TheWaffleGuy/EPROM-programmer/3D/CUI_DEVICES_HSE-B2111-038.step

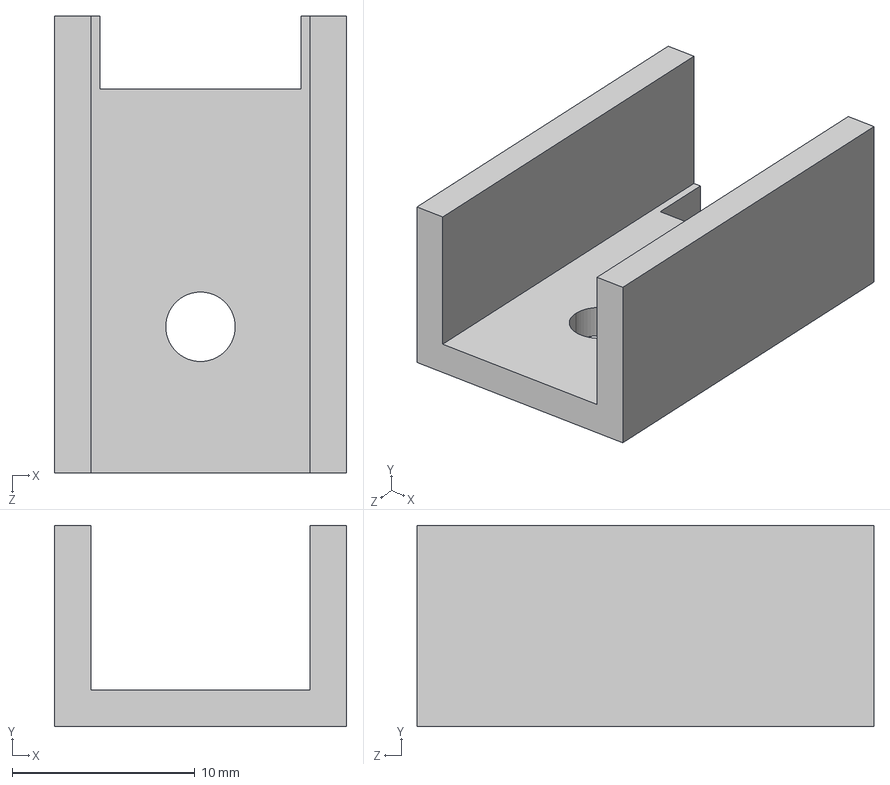
[picture p1: CAD file, 2024-07-29]
3D/CUI_DEVICES_HSE-B2111-038.step
16.0 x 11.0 x 25.0 mm
