TheWaffleGuy/EPROM-programmer/3D/224-1275-00-0602J--3DModel-STEP-56544.STEP

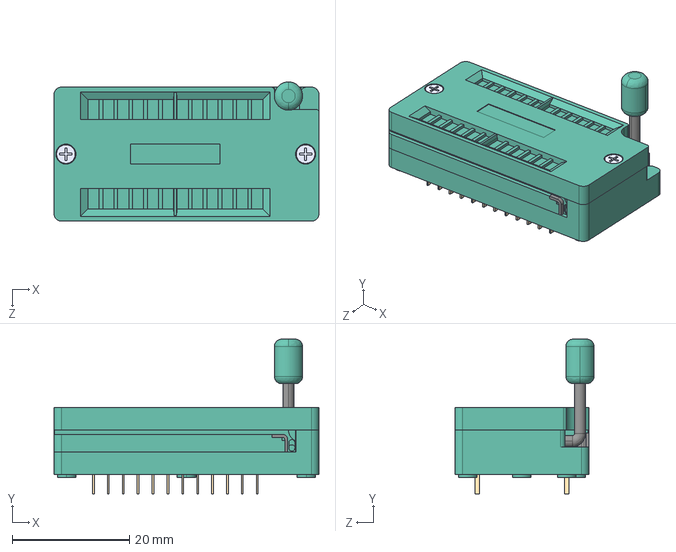
[picture p2: CAD file, 2023-07-26]
3D/224-1275-00-0602J--3DModel-STEP-56544.STEP
45.2 x 26.4 x 23.7 mm
