TheWaffleGuy/EPROM-programmer/EPROM-programmer.kicad_pcb

## KiCad design EPROM-programmer.kicad_pcb (2025-09-11)

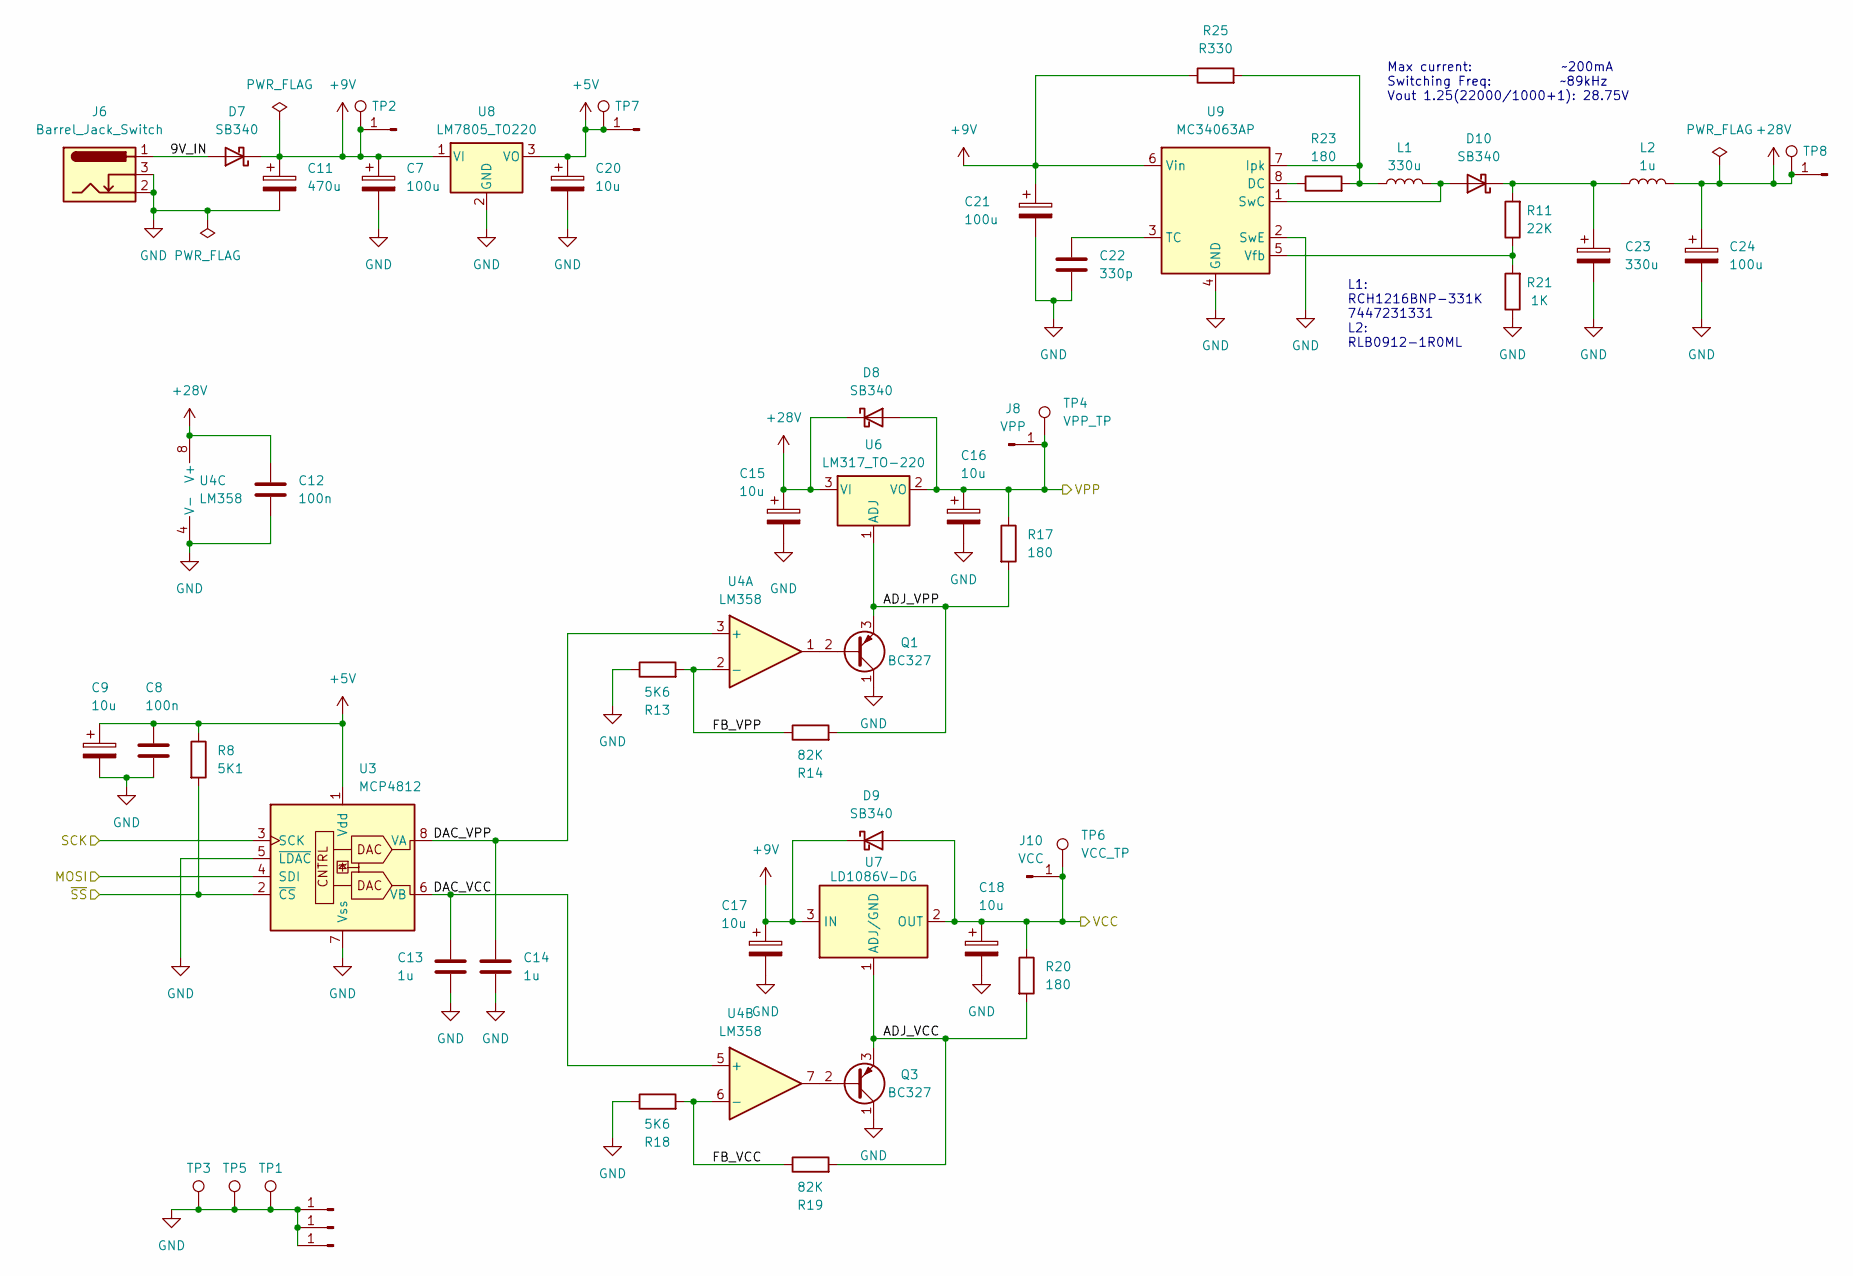
[picture p3: schematic Power.kicad_sch]

Parts:
C7, C21, C24: 100u; CP_Radial_D6.3mm_P2.50mm
C8, C12: 100n; C_Rect_L4.6mm_W3.0mm_P2.50mm_MKS02_FKP02
C9, C15, C16, C17, C18: 10u; C_Rect_L4.6mm_W3.0mm_P2.50mm_MKS02_FKP02
C11: 470u; CP_Radial_D10.0mm_P5.00mm
C13, C14: 1u; C_Rect_L4.6mm_W3.0mm_P2.50mm_MKS02_FKP02
C20: 10u; CP_Radial_D6.3mm_P2.50mm
C22: 330p; C_Rect_L4.6mm_W3.0mm_P2.50mm_MKS02_FKP02
C23: 330u; CP_Radial_D10.0mm_P5.00mm
D7, D8, D9, D10: SB340; D_DO-201AD_P5.08mm_Vertical_KathodeUp
J3, J5, J9: GND; PinHeader_1x01_P2.54mm_Vertical
J4: 9V; PinHeader_1x01_P2.54mm_Vertical
J6: Barrel_Jack_Switch; BarrelJack_Horizontal
J8: VPP; PinHeader_1x01_P2.54mm_Vertical
J10: VCC; PinHeader_1x01_P2.54mm_Vertical
J11: 5V; PinHeader_1x01_P2.54mm_Vertical
J12: 28V; PinHeader_1x01_P2.54mm_Vertical
L1: 330u; L_Radial_D12.5mm_P4.00mm_5.00mm
L2: 1u; L_Radial_D8.7mm_P5.00mm_Fastron_07HCP
Q1, Q3: BC327; TO-92_Inline_Wide
R8: 5K1; R_Axial_DIN0207_L6.3mm_D2.5mm_P10.16mm_Horizontal
R11: 22K; R_Axial_DIN0207_L6.3mm_D2.5mm_P10.16mm_Horizontal
R13, R18: 5K6; R_Axial_DIN0207_L6.3mm_D2.5mm_P10.16mm_Horizontal
R14, R19: 82K; R_Axial_DIN0207_L6.3mm_D2.5mm_P10.16mm_Horizontal
R17, R20, R23: 180; R_Axial_DIN0207_L6.3mm_D2.5mm_P10.16mm_Horizontal
R21: 1K; R_Axial_DIN0207_L6.3mm_D2.5mm_P10.16mm_Horizontal
R25: R330; R_Axial_DIN0207_L6.3mm_D2.5mm_P10.16mm_Horizontal
TP1, TP3, TP5: GND; TestPoint_Pad_2.0x2.0mm
TP2: 12V; TestPoint_Pad_2.0x2.0mm
TP4: VPP_TP; TestPoint_Pad_2.0x2.0mm
TP6: VCC_TP; TestPoint_Pad_2.0x2.0mm
TP7: 5V; TestPoint_Pad_2.0x2.0mm
TP8: 28V; TestPoint_Pad_2.0x2.0mm
U3: MCP4812; DIP-8_W7.62mm_Socket
U4: LM358; DIP-8_W7.62mm_Socket
U6: LM317_TO-220; TO-220-3_Vertical
U7: LD1086V-DG; TO-220-3_Horizontal_TabDown
U8: LM7805_TO220; TO-220-3_Horizontal_TabDown
U9: MC34063AP; DIP-8_W7.62mm

Connections:
+5V: C8.1, C9.1, C20.1, J11.1, R8.1, TP7.1, U3.1 (Vdd), U8.3 (VO); also elsewhere on the board
+9V: C7.1, C11.1, C17.1, C21.1, D7.1 (K), D9.1 (K), J4.1, R25.1, TP2.1, U7.3 (IN), U8.1 (VI), U9.6 (Vin)
+28V: C12.1, C15.1, C24.1, D8.1 (K), J12.1, L2.2, TP8.1, U4.8 (V+), U6.3 (VI)
/Power/9V_IN: D7.2 (A), J6.1
/Power/ADJ_VCC: Q3.3 (E), R19.2, R20.2, U7.1 (ADJ/GND)
/Power/ADJ_VPP: Q1.3 (E), R14.2, R17.2, U6.1 (ADJ)
/Power/DAC_VCC: C13.1, U3.6 (VB), U4.5 (+)
/Power/DAC_VPP: C14.1, U3.8 (VA), U4.3 (+)
/Power/FB_VCC: R18.2, R19.1, U4.6 (-)
/Power/FB_VPP: R13.2, R14.1, U4.2 (-)
/Power/VCC: C18.1, D9.2 (A), J10.1, R20.1, TP6.1, U7.2 (OUT); also elsewhere on the board
/Power/VPP: C16.1, D8.2 (A), J8.1, R17.1, TP4.1, U6.2 (VO); also elsewhere on the board
/Power/~SS: R8.2, U3.2 (~CS); also elsewhere on the board
/Programmer/MOSI: U3.4 (SDI); also elsewhere on the board
/Programmer/SCK: U3.3 (SCK); also elsewhere on the board
GND: C7.2, C8.2, C9.2, C11.2, C12.2, C13.2, C14.2, C15.2, C16.2, C17.2, C18.2, C20.2, C21.2, C22.2, C23.2, C24.2, J3.1, J5.1, J6.2, J6.3, J9.1, Q1.1 (C), Q3.1 (C), R13.1, R18.1, R21.1, TP1.1, TP3.1, TP5.1, U3.5 (~LDAC), U3.7 (Vss), U4.4 (V-), U8.2 (GND), U9.2 (SwE), U9.4 (GND); also elsewhere on the board
unnamed: D10.2 (A), L1.2, U9.1 (SwC)
unnamed: C23.1, D10.1 (K), L2.1, R11.2
unnamed: Q1.2 (B), U4.1
unnamed: Q3.2 (B), U4.7
unnamed: R23.1, U9.8 (DC)
unnamed: L1.1, R23.2, R25.2, U9.7 (Ipk)
unnamed: C22.1, U9.3 (TC)
unnamed: R11.1, R21.2, U9.5 (Vfb)

Notes on the sheet:
L1: RCH1216BNP-331K 7447231331 L2: RLB0912-1R0ML
Max current: ~200mA Switching Freq: ~89kHz Vout 1.25(22000/1000+1): 28.75V

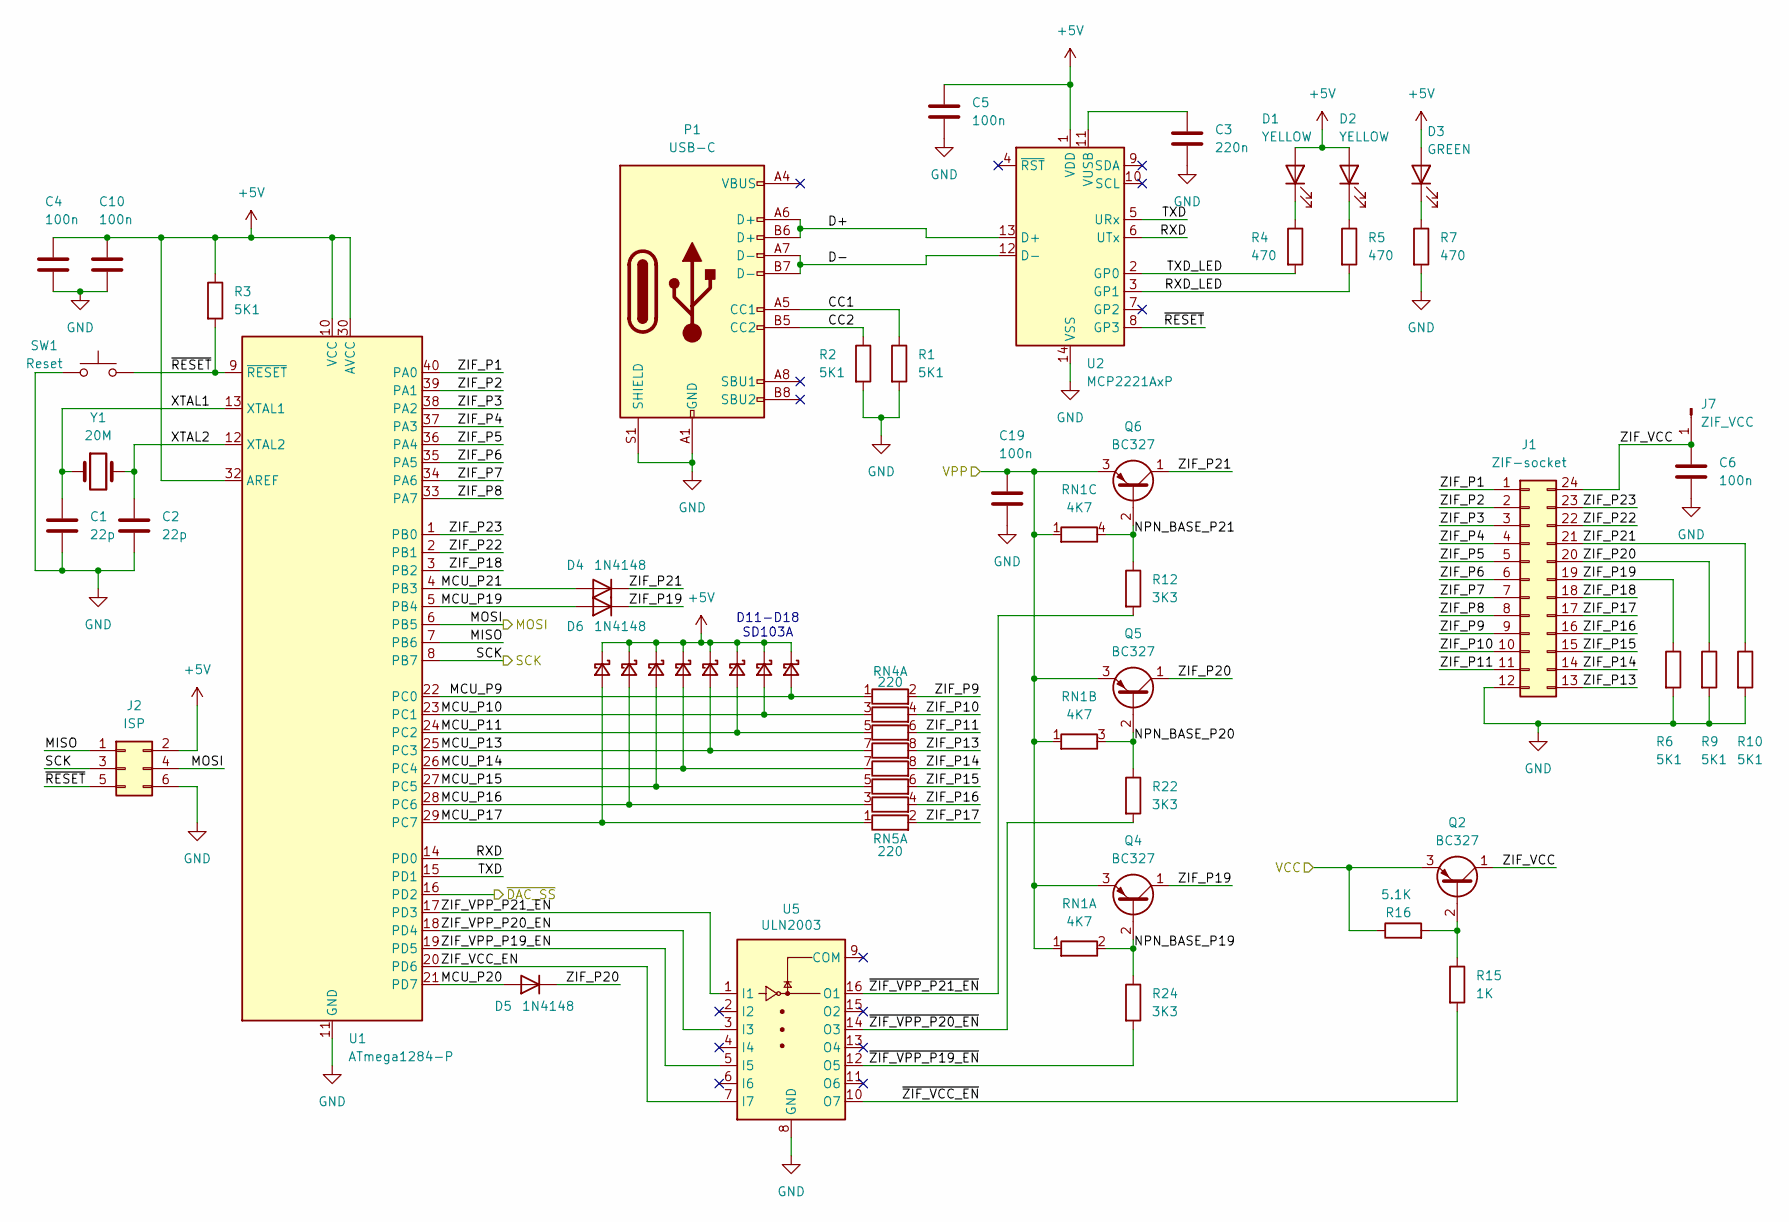
[picture p4: schematic Programmer.kicad_sch]

Parts:
C1, C2: 22p; C_Rect_L4.6mm_W3.0mm_P2.50mm_MKS02_FKP02
C3: 220n; C_Rect_L4.6mm_W3.0mm_P2.50mm_MKS02_FKP02
C4, C5, C6, C10, C19: 100n; C_Rect_L4.6mm_W3.0mm_P2.50mm_MKS02_FKP02
D1, D2: YELLOW; LED_D3.0mm
D3: GREEN; LED_D3.0mm
D4, D5, D6: 1N4148; D_DO-35_SOD27_P7.62mm_Horizontal
D11, D12, D13, D14, D15, D16, D17, D18: SD103A; D_DO-35_SOD27_P7.62mm_Horizontal
J1: ZIF-socket; DIP_Socket-24_W11.9_W12.7_W15.24_W17.78_W18.5_3M_224-1275-0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
J2: ISP; IDC-Header_2x03_P2.54mm_Vertical
J7: ZIF_VCC; PinHeader_1x01_P2.54mm_Vertical
P1: USB-C; USB_C_Receptacle_GCT_USB4085
Q2, Q4, Q5, Q6: BC327; TO-92_Inline_Wide
R1, R2, R3, R6, R9, R10: 5K1; R_Axial_DIN0207_L6.3mm_D2.5mm_P10.16mm_Horizontal
R4, R5, R7: 470; R_Axial_DIN0207_L6.3mm_D2.5mm_P10.16mm_Horizontal
R12, R22, R24: 3K3; R_Axial_DIN0207_L6.3mm_D2.5mm_P10.16mm_Horizontal
R15: 1K; R_Axial_DIN0207_L6.3mm_D2.5mm_P10.16mm_Horizontal
R16: 5.1K; R_Axial_DIN0207_L6.3mm_D2.5mm_P10.16mm_Horizontal
RN1: 4K7; R_Array_SIP4
RN4, RN5: 220; R_Array_SIP8
SW1: Reset; SW_PUSH_6mm
U1: ATmega1284-P; DIP-40_W15.24mm_Socket
U2: MCP2221AxP; DIP-14_W7.62mm_Socket
U5: ULN2003; DIP-16_W7.62mm
Y1: 20M; Crystal_HC49-U_Vertical

Connections:
+5V: C4.1, C5.1, C10.1, D1.2 (A), D2.2 (A), D3.2 (A), D11.1 (K), D12.1 (K), D13.1 (K), D14.1 (K), D15.1 (K), D16.1 (K), D17.1 (K), D18.1 (K), J2.2, R3.1, U1.10 (VCC), U1.30 (AVCC), U1.32 (AREF), U2.1 (VDD); also elsewhere on the board
/Power/VCC: Q2.3 (E), R16.1; also elsewhere on the board
/Power/VPP: C19.1, Q4.3 (E), Q5.3 (E), Q6.3 (E), RN1.1 (R1); also elsewhere on the board
/Power/~SS: U1.16 (PD2); also elsewhere on the board
/Programmer/CC1: P1.A5 (CC1), R1.1
/Programmer/CC2: P1.B5 (CC2), R2.1
/Programmer/D+: P1.A6 (D+), P1.B6 (D+), U2.13 (D+)
/Programmer/D-: P1.A7 (D-), P1.B7 (D-), U2.12 (D-)
/Programmer/MCU_P9: D18.2 (A), RN4.1 (R1.1), U1.22 (PC0)
/Programmer/MCU_P10: D17.2 (A), RN4.3 (R2.1), U1.23 (PC1)
/Programmer/MCU_P11: D16.2 (A), RN4.5 (R3.1), U1.24 (PC2)
/Programmer/MCU_P13: D15.2 (A), RN4.7 (R4.1), U1.25 (PC3)
/Programmer/MCU_P14: D14.2 (A), RN5.7 (R4.1), U1.26 (PC4)
/Programmer/MCU_P15: D13.2 (A), RN5.5 (R3.1), U1.27 (PC5)
/Programmer/MCU_P16: D12.2 (A), RN5.3 (R2.1), U1.28 (PC6)
/Programmer/MCU_P17: D11.2 (A), RN5.1 (R1.1), U1.29 (PC7)
/Programmer/MCU_P19: D6.2 (A), U1.5 (PB4)
/Programmer/MCU_P20: D5.2 (A), U1.21 (PD7)
/Programmer/MCU_P21: D4.2 (A), U1.4 (PB3)
/Programmer/MISO: J2.1, U1.7 (PB6)
/Programmer/MOSI: J2.4, U1.6 (PB5); also elsewhere on the board
/Programmer/NPN_BASE_P19: Q4.2 (B), R24.1, RN1.2 (R1.2)
/Programmer/NPN_BASE_P20: Q5.2 (B), R22.1, RN1.3 (R2.2)
/Programmer/NPN_BASE_P21: Q6.2 (B), R12.1, RN1.4 (R3.2)
/Programmer/RXD: U1.14 (PD0), U2.6 (UTx)
/Programmer/RXD_LED: R5.2, U2.3 (GP1)
/Programmer/SCK: J2.3, U1.8 (PB7); also elsewhere on the board
/Programmer/TXD: U1.15 (PD1), U2.5 (URx)
/Programmer/TXD_LED: R4.2, U2.2 (GP0)
/Programmer/XTAL1: C1.1, U1.13 (XTAL1), Y1.1
/Programmer/XTAL2: C2.1, U1.12 (XTAL2), Y1.2
/Programmer/ZIF_P1: J1.1, U1.40 (PA0)
/Programmer/ZIF_P2: J1.2, U1.39 (PA1)
/Programmer/ZIF_P3: J1.3, U1.38 (PA2)
/Programmer/ZIF_P4: J1.4, U1.37 (PA3)
/Programmer/ZIF_P5: J1.5, U1.36 (PA4)
/Programmer/ZIF_P6: J1.6, U1.35 (PA5)
/Programmer/ZIF_P7: J1.7, U1.34 (PA6)
/Programmer/ZIF_P8: J1.8, U1.33 (PA7)
/Programmer/ZIF_P9: J1.9, RN4.2 (R1.2)
/Programmer/ZIF_P10: J1.10, RN4.4 (R2.2)
/Programmer/ZIF_P11: J1.11, RN4.6 (R3.2)
/Programmer/ZIF_P13: J1.13, RN4.8 (R4.2)
/Programmer/ZIF_P14: J1.14, RN5.8 (R4.2)
/Programmer/ZIF_P15: J1.15, RN5.6 (R3.2)
/Programmer/ZIF_P16: J1.16, RN5.4 (R2.2)
/Programmer/ZIF_P17: J1.17, RN5.2 (R1.2)
/Programmer/ZIF_P18: J1.18, U1.3 (PB2)
/Programmer/ZIF_P19: D6.1 (K), J1.19, Q4.1 (C), R6.1
/Programmer/ZIF_P20: D5.1 (K), J1.20, Q5.1 (C), R9.1
/Programmer/ZIF_P21: D4.1 (K), J1.21, Q6.1 (C), R10.1
/Programmer/ZIF_P22: J1.22, U1.2 (PB1)
/Programmer/ZIF_P23: J1.23, U1.1 (PB0)
/Programmer/ZIF_VCC: C6.1, J1.24, J7.1, Q2.1 (C)
/Programmer/ZIF_VCC_EN: U1.20 (PD6), U5.7 (I7)
/Programmer/ZIF_VPP_P19_EN: U1.19 (PD5), U5.5 (I5)
/Programmer/ZIF_VPP_P20_EN: U1.18 (PD4), U5.3 (I3)
/Programmer/ZIF_VPP_P21_EN: U1.17 (PD3), U5.1 (I1)
/Programmer/~RESET: J2.5, R3.2, SW1.2, U1.9 (~RESET), U2.8 (GP3)
/Programmer/~ZIF_VCC_EN: R15.2, U5.10 (O7)
/Programmer/~ZIF_VPP_P19_EN: R24.2, U5.12 (O5)
/Programmer/~ZIF_VPP_P20_EN: R22.2, U5.14 (O3)
/Programmer/~ZIF_VPP_P21_EN: R12.2, U5.16 (O1)
GND: C1.2, C2.2, C3.2, C4.2, C5.2, C6.2, C10.2, C19.2, J1.12, J2.6, P1.A1 (GND), P1.A12 (GND), P1.B1 (GND), P1.B12 (GND), P1.S1 (SHIELD), R1.2, R2.2, R6.2, R7.2, R9.2, R10.2, SW1.1, U1.11 (GND), U1.31 (GND), U2.14 (VSS), U5.8 (GND); also elsewhere on the board
unnamed: D1.1 (K), R4.1
unnamed: D2.1 (K), R5.1
unnamed: D3.1 (K), R7.1
unnamed: Q2.2 (B), R15.1, R16.2
unnamed: C3.1, U2.11 (VUSB)

Notes on the sheet:
D11-D18 SD103A

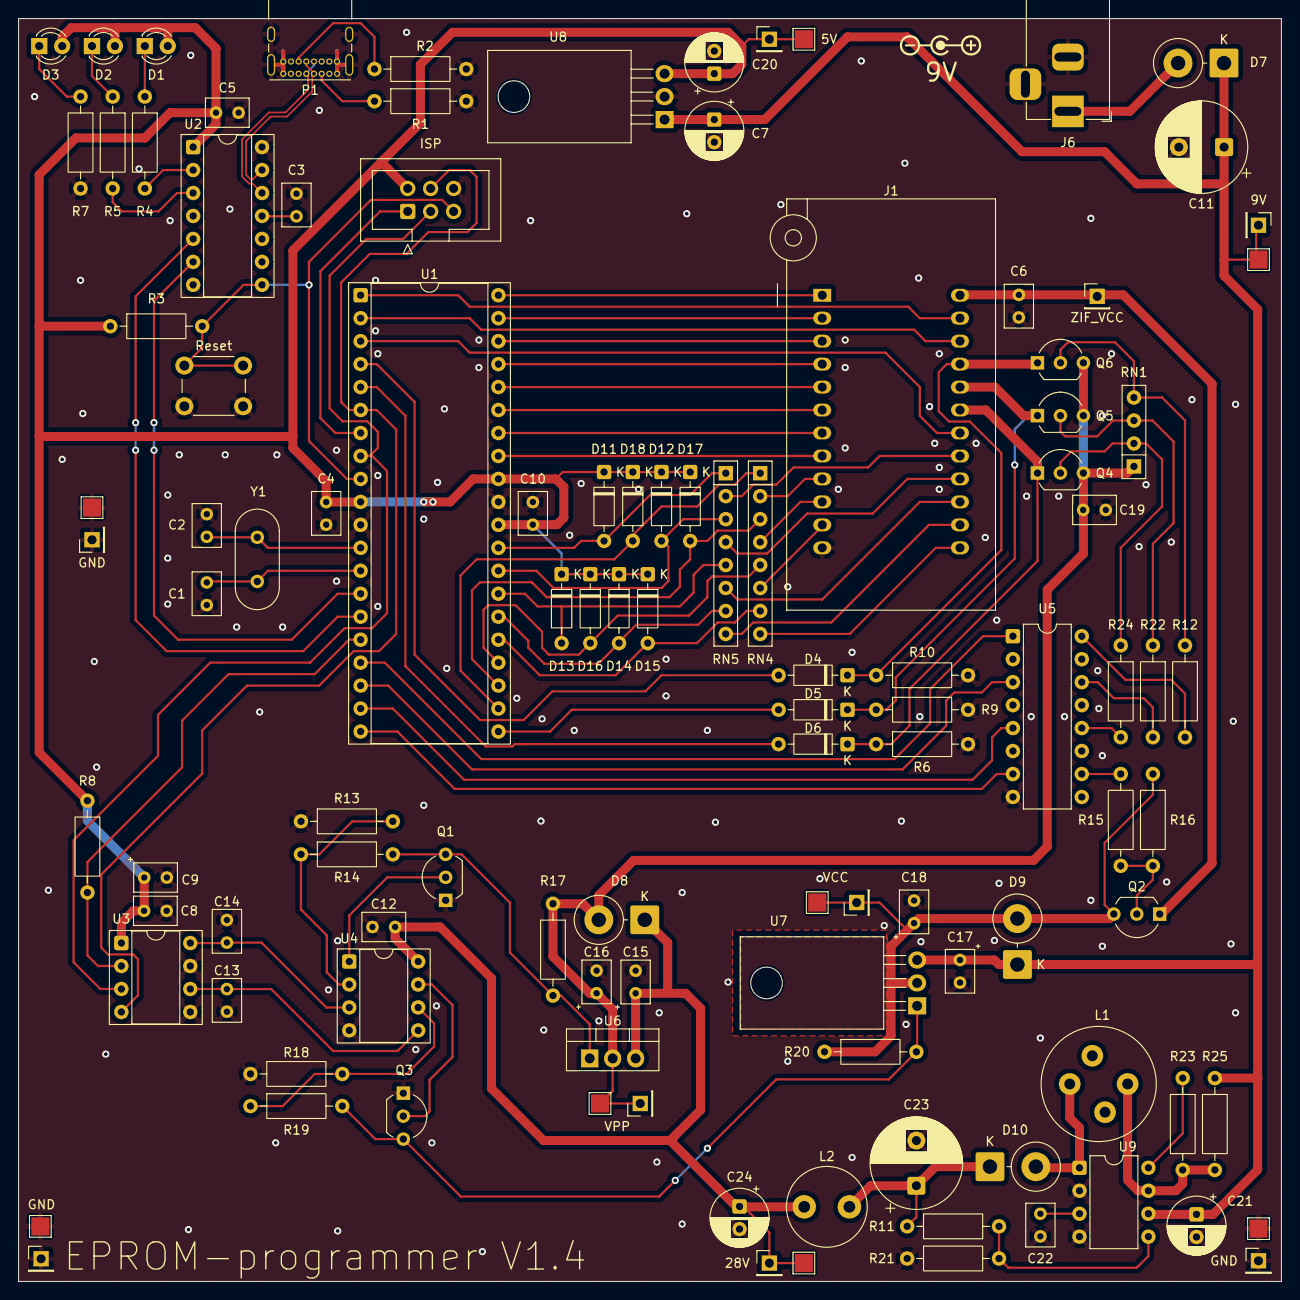
[picture p5: board EPROM-programmer.kicad_pcb from above]

Board: 2 copper layers, 139.7 x 139.7 mm, 110 parts (0 on the bottom side), 86 nets.
