TheWaffleGuy/EPROM-programmer/mock_arduino.cpp

#include <stdint.h>
#include <cstring>
#include <iostream>
#include <iomanip>
#include <string>
#include <stdarg.h>
#include <algorithm>
#include <math.h>

#ifdef __linux__ 
#include <termios.h>
#include <stdio.h>
#include <time.h>
#include <sys/ioctl.h>

void delay(unsigned long milliseconds)
{
    struct timespec ts;
    ts.tv_sec = milliseconds / 1000;
    ts.tv_nsec = (milliseconds % 1000) * 1000000;
    nanosleep(&ts, NULL);
}

static struct termios old;

/* Initialize new terminal i/o settings */
void initTermios(int echo) 
{
  static struct termios current;
  tcgetattr(0, &old); /* grab old terminal i/o settings */
  current = old; /* make new settings same as old settings */
  current.c_lflag &= ~ICANON; /* disable buffered i/o */
  if (echo) {
      current.c_lflag |= ECHO; /* set echo mode */
  } else {
      current.c_lflag &= ~ECHO; /* set no echo mode */
  }
  tcsetattr(0, TCSANOW, &current); /* use these new terminal i/o settings now */
}

/* Restore old terminal i/o settings */
void resetTermios(void) 
{
  tcsetattr(0, TCSANOW, &old);
}

char getch()
{
  int c = getchar();
  if (c == 127) return 8;
  return c;
}

bool kbhit()
{
  int byteswaiting;
  ioctl(0, FIONREAD, &byteswaiting);
  return byteswaiting > 0;
}

#elif _WIN32
#include <conio.h>
#include <windows.h>
void delay(unsigned long milliseconds)
{
  Sleep(milliseconds);
}
#endif

#define F_CPU 20000000L

#define PROGMEM
#define memcpy_P memcpy
#define __FlashStringHelper char

#define ATOMIC_BLOCK(type) for (int __ToDo=1; __ToDo; __ToDo=0)

#define INPUT 0x0
#define OUTPUT 0x1

#define DEC 10
#define HEX 16
#define OCT 8
#ifdef BIN // Prevent warnings if BIN is previously defined in "iotnx4.h" or similar
#undef BIN
#endif
#define BIN 2

//typedef std::string String;

//Registers
uint8_t SREG = 0;
uint8_t DDRA = 0;
uint8_t DDRB = 0;
uint8_t DDRC = 0;
uint8_t DDRD = 0;
uint8_t PORTA = 0;
uint8_t PORTB = 0;
uint8_t PORTC = 0;
uint8_t PORTD = 0;
uint8_t PINA = 0;
uint8_t PINB = 0;
uint8_t PINC = 0;
uint8_t PIND = 0;

const uint8_t* port_to_mode[] =
{
  NULL,
  &DDRA,
  &DDRB,
  &DDRC,
  &DDRD,
};

uint8_t* port_to_output[] =
{
  NULL,
  &PORTA,
  &PORTB,
  &PORTC,
  &PORTD,
};

uint8_t* port_to_input[] =
{
  NULL,
  &PINA,
  &PINB,
  &PINC,
  &PIND,
};

//Functions


void portMode(uint8_t PORT, uint8_t MODE){};
void cli() {};
int isDigit(int c)
{
  return ( isdigit (c) == 0 ? false : true);
}
void portWrite(uint8_t PORT, uint8_t VALUE)
{
  PORT++;
  *(port_to_output[PORT]) = VALUE;
}

uint8_t portRead(uint8_t PORT)
{
  PORT++;
  return *(port_to_input[PORT]);
}

// String class
namespace {
std::string ReplaceAll(std::string str, const std::string& from, const std::string& to) {
  size_t start_pos = 0;
  while((start_pos = str.find(from, start_pos)) != std::string::npos) {
    str.replace(start_pos, from.length(), to);
    start_pos += to.length(); // Handles case where 'to' is a substring of 'from'
  }
  return str;
}
}

class String : public std::string {
  public:
    String() {}
    String(const String& string) : String(string.c_str()) {}
    String(const std::string& string) : std::string(string) {}
    String(const char* string) : std::string(string) {}

    String substring(int start) {
      return substr(start);
    }
    String substring(int start, int end) {
      return substr(start, end - start);
    }

    String remove(int start) {
      return erase(start);
    }

    void replace(const String& from, const String& to) {
      ReplaceAll(*this, from, to);
    }

    int indexOf(const char needle) {
      return find(needle);
    }

    void trim() {
      erase(begin(), std::find_if(begin(), end(), [](unsigned char ch) {
        return !std::isspace(ch);
      }));
      erase(std::find_if(rbegin(), rend(), [](unsigned char ch) {
        return !std::isspace(ch);
      }).base(), end());
    }

    long toInt(void) const
    {
      return atol(c_str());
    }
};

//Serial class

class FakeSerial {
public:
  FakeSerial() {
    #ifdef __linux__ 
    initTermios(0);
    #endif
  }

  void begin(unsigned long) {}
  void end() {}

  int read() {
    if(!available()) return -1;
    int c = getch();
    if (c == '\r') return '\n';
    return c;
  }

  size_t write(char c) {
    std::cout << c << std::flush;
    return 1;
  }
  size_t write(const unsigned char buf[], size_t size) {
    std::cout << std::string((char*)buf,size);
    return size;
  }

  size_t write(const char *str) {
    if (str == NULL) return 0;
    return write((const uint8_t *)str, strlen(str));
  }

  size_t write(const char *buffer, size_t size) {
    return write((const uint8_t *)buffer, size);
  }

  size_t print(const String &s)
  {
    return write(s.c_str(), s.length());
  }

  size_t print(const char str[])
  {
    return write(str);
  }

  size_t print(char c)
  {
    return write(c);
  }

  size_t print(unsigned char b, int base)
  {
    return print((unsigned long) b, base);
  }

  size_t print(int n, int base)
  {
    return print((long) n, base);
  }

  size_t print(unsigned int n, int base)
  {
    return print((unsigned long) n, base);
  }

  size_t print(long n, int base)
  {
    if (base == 0) {
      return write(n);
    } else if (base == 10) {
      if (n < 0) {
        int t = print('-');
        n = -n;
        return printNumber(n, 10) + t;
      }
      return printNumber(n, 10);
    } else {
      return printNumber(n, base);
    }
  }

  size_t print(unsigned long n, int base)
  {
    if (base == 0) return write(n);
    else return printNumber(n, base);
  }

  size_t println(void)
  {
    return write("\r\n");
  }

  size_t println(const String &s)
  {
    size_t n = print(s);
    n += println();
    return n;
  }

  size_t println(const char c[])
  {
    size_t n = print(c);
    n += println();
    return n;
  }

  size_t println(char c)
  {
    size_t n = print(c);
    n += println();
    return n;
  }

  size_t println(unsigned char b, int base)
  {
    size_t n = print(b, base);
    n += println();
    return n;
  }

  size_t println(int num, int base)
  {
    size_t n = print(num, base);
    n += println();
    return n;
  }

  size_t println(unsigned int num, int base)
  {
    size_t n = print(num, base);
    n += println();
    return n;
  }

  size_t println(long num, int base)
  {
    size_t n = print(num, base);
    n += println();
    return n;
  }

  size_t println(unsigned long num, int base)
  {
    size_t n = print(num, base);
    n += println();
    return n;
  }

  int16_t printf(const char *format, ...)
  {
    va_list ap;
    va_start(ap, format);
    return vprintf(format, ap);
  }

  int available()
  {
    return kbhit();
  }

  String readStringUntil(char terminator)
  {
    using namespace std;
    String ret;
    std::getline (cin, ret, terminator);
    return ret;
  }

  ~FakeSerial() {
    #ifdef __linux__ 
    resetTermios();
    #endif
  }

private:
size_t printNumber(unsigned long n, uint8_t base)
  {
    char buf[8 * sizeof(long) + 1]; // Assumes 8-bit chars plus zero byte.
    char *str = &buf[sizeof(buf) - 1];

    *str = '\0';

    // prevent crash if called with base == 1
    if (base < 2) base = 10;

    do {
      char c = n % base;
      n /= base;

      *--str = c < 10 ? c + '0' : c + 'A' - 10;
    } while(n);

    return write(str);
  }
};

FakeSerial Serial;


#include <bitset>

#ifndef LSBFIRST
#define LSBFIRST 0
#endif
#ifndef MSBFIRST
#define MSBFIRST 1
#endif

#define SPI_MODE0 0x00
#define SPI_MODE1 0x04
#define SPI_MODE2 0x08
#define SPI_MODE3 0x0C

class SPISettings {
public:
  SPISettings(uint32_t clock, uint8_t bitOrder, uint8_t dataMode) {
  }
};

class FakeSPI {
public:
  static void begin() {
    std::cout << "SPI-debug: " << "begin" << std::endl;
  }
  static void beginTransaction(SPISettings settings) {
    std::cout << "SPI-debug: " << "beginTransaction" << std::endl;
  }
  static void endTransaction() {
    std::cout << "SPI-debug: " << "endTransaction" << std::endl;
  }
  static uint8_t transfer(uint8_t data) {
    std::cout << "SPI-debug: " << "transfer: " << std::bitset<8>(data) << std::endl;
    return data;
  }
  static uint16_t transfer16(uint16_t data) {
    std::cout << "SPI-debug: " << "transfer: " << std::bitset<16>(data) << std::endl;
    return data;
  }
};

FakeSPI SPI;
