TheWaffleGuy/EPROM-programmer/test2.cpp

#include "mock_arduino.cpp"

#include "firmware/firmware.ino"
#include "firmware/kk_srec.c"

int main() {
    setup();
    memcpy(buffer,
        "Lorem ipsum dolor sit amet, consectetur adipiscing elit. Sed euismod, arcu id faucibus mattis, erat nisi consectetur nisi, nec blandit quam lorem sed lectus. Quisque magna elit, auctor non nibh vel, interdum aliquet ligula. Morbi odio elit, tristique sit amet commodo quis, varius vel lorem. Quisque vel gravida libero. Suspendisse sodales dapibus est a rhoncus. Nulla eu porttitor magna, et maximus ligula. Sed ex turpis, facilisis vitae nisi id, lobortis varius enim. Sed malesuada rutrum velit. Phasellus bibendum felis vitae velit imperdiet laoreet. Orci varius natoque penatibus et magnis dis parturient montes, nascetur ridiculus mus. Vestibulum consectetur sem vel mattis pellentesque.\n"
        "Nullam scelerisque quam nisl, sit amet consequat enim aliquet nec. Vivamus tincidunt dolor nibh, id iaculis nisi maximus non. Sed leo nunc, vulputate id lorem eget, fermentum hendrerit mi. Aenean et eleifend justo, vitae semper sem. Aenean vulputate ex sed venenatis ultricies. Praesent laoreet ligula ligula, vestibulum consequat libero ornare sed. Praesent tincidunt ipsum at sagittis posuere. Interdum et malesuada fames ac ante ipsum primis in faucibus. Cras lobortis, velit et porta semper, nunc nulla pharetra nibh, eu faucibus augue felis at felis.\n"
        "Morbi consequat quam vel lacus vulputate rutrum. Morbi sollicitudin at augue vel dictum. Nullam elementum ligula quis tristique lobortis. Maecenas sapien lacus, congue ut ipsum et, mattis vestibulum magna. Proin id accumsan magna. Mauris lobortis ex id ex accumsan interdum. Mauris vulputate sem sed felis ultrices gravida. Donec egestas orci in sodales ultricies.\n"
        "Morbi consectetur fringilla purus, vel vehicula massa dignissim ut. Donec sed velit a arcu molestie ultricies vitae quis arcu. Nunc varius leo at commodo eleifend. Aliquam vel quam est. Donec vehicula pellentesque leo, eget ultrices augue interdum non. Quisque tempor nulla quis odio vestibulum, ac faucibus tortor pretium. Etiam nec sagittis odio. Sed commodo metus sed metus facilisis, tincidunt fringilla lectus egestas. Nullam volutpat id neque quis sodales. Nullam vitae vehicula ex. Pellentesque ullamcorper risus sed elit commodo, nec vehicula ex gravida.\n"
        "Praesent molestie elementum massa sed condimentum. Sed ante orci, pulvinar a imperdiet sit amet, faucibus accumsan justo. Donec quis tristique felis. Morbi ac tincidunt mauris, at iaculis quam. Ut dolor ipsum, vehicula id mattis in, auctor quis lectus. Vestibulum auctor augue a sagittis finibus. Nulla lobortis leo non odio laoreet faucibus. Integer eget consectetur ex. Donec augue quam, rutrum et velit sed, ultricies scelerisque metus. Duis dictum viverra suscipit. Maecenas varius augue in est congue, eget congue orci lacinia. Nulla nec semper orci. Cras viverra neque orci, vel sodales sem scelerisque fringilla. Nullam ligula dui, scelerisque non ipsum sit amet, luctus euismod nibh. Nam sem lectus, lobortis quis ultrices vitae, convallis interdum urna. Duis mi tellus, tempor in ex a, accumsan molestie eros.\n"
        "Pellentesque at urna non magna posuere venenatis. Proin hendrerit tortor ut magna ornare viverra. Sed sodales turpis a dui imperdiet pharetra. In tempus, dolor non ornare auctor, tortor eros finibus orci, a accumsan nulla orci quis nibh. Suspendisse eget blandit nulla. Vivamus sit amet lectus sem. Mauris pellentesque rhoncus faucibus. Phasellus et velit tristique, scelerisque enim vel, commodo elit. Sed dapibus cursus erat, sed imperdiet justo porttitor quis. Donec purus ligula, elementum ut sodales non, fermentum id odio. Maecenas vestibulum est vitae elit hendrerit laoreet. Pellentesque fermentum blandit nibh, ac maximus leo. Nullam orci dolor, mattis non lacinia sit amet, dignissim ut sem. Nam sit amet ante quis arcu bibendum egestas vitae eu nisi. Vestibulum ante ipsum primis in faucibus orci luctus et ultrices posuere cubilia curae;\n"
        "Pellentesque et libero quis nibh posuere consectetur non vel eros. Phasellus nec dolor mattis, efficitur justo pulvinar, placerat nisi. Duis eget ex ac turpis gravida vehicula a et nibh. Cras vel arcu quam. Pellentesque vehicula, magna sit amet cursus dignissim, est enim volutpat tellus, eu tempor magna odio eget diam. Praesent sodales, tellus non pulvinar condimentum, tortor est vestibulum ex, eget ultrices sapien velit in arcu. Nunc nisi lacus, auctor faucibus egestas ut, sagittis viverra justo.\n"
        "Sed eros augue, tincidunt a sem nec, blandit ornare est. Integer euismod imperdiet egestas. Donec lobortis, magna et sollicitudin fermentum, dolor lorem convallis orci, sit amet cursus dolor eros interdum ex. Nulla augue velit, efficitur ac orci eu, tincidunt egestas enim. Praesent tincidunt nulla non ornare convallis. Curabitur dapibus consectetur odio eget congue. Cras erat libero, faucibus id viverra ut, porttitor in mi. Curabitur tristique porttitor venenatis. Suspendisse justo risus, lobortis eu rutrum ac, pharetra nec velit. Nullam fringilla tortor nec tortor molestie, at ultricies nulla porta. Aenean feugiat volutpat nulla, id bibendum odio accumsan in.\n"
        "Integer posuere purus nec felis dapibus, eu sollicitudin dui tincidunt. Aenean vel eros dignissim, vulputate magna nec, facilisis ante. Nam id erat ut odio fermentum imperdiet at non libero. Donec finibus nibh nec massa pretium, a congue odio elementum. Nam et efficitur sem. Pellentesque non velit id magna iaculis porta in vehicula nisi. Quisque nec ex risus. Orci varius natoque penatibus et magnis dis parturient montes, nascetur ridiculus mus. Mauris porta sed nisi ut dictum. Duis eu condimentum arcu, a elementum nisi.\n"
        "Proin sed arcu orci. Praesent dignissim dignissim diam eget accumsan. Sed varius a leo et tristique. Cras maximus eleifend ex, at feugiat ante convallis id. Aliquam sodales mauris sit amet arcu faucibus lobortis. Praesent sit amet ex sit amet massa hendrerit ornare. Cras elementum venenatis interdum. Aenean convallis, libero quis condimentum bibendum, quam tellus lobortis ligula, nec bibendum lacus erat vitae dolor. Phasellus gravida tortor iaculis, hendrerit risus eget, vehicula est. Pellentesque bibendum nec lacus vel mattis. In et viverra lacus, sit amet imperdiet metus. In vitae metus eu justo tempus rutrum mattis vel nulla. Duis sit amet nisl et ante accumsan laoreet in at nulla. Sed justo elit, cursus in eros sit amet, cursus ullamcorper nibh. Ut a tellus eu lacus placerat porttitor. Fusce efficitur nisi nisi, ac semper sem fringilla cursus.\n"
        "Donec hendrerit elit sit amet condimentum interdum. Donec id aliquam elit. Nulla facilisi. Sed tristique nisi id sapien feugiat lobortis. Vestibulum et velit sed arcu fermentum tempus ac vitae orci. Donec sit amet nulla gravida, aliquet ex at, varius lorem. Duis sit amet metus tellus. Aenean nisi sem, suscipit id tincidunt nec, rutrum in augue. Fusce in sapien tempus, lacinia ligula sed, suscipit felis. Vestibulum blandit velit et arcu semper venenatis. Aliquam magna ipsum, scelerisque ut fermentum at, volutpat at risus. Aliquam mollis sapien tempus sem iaculis, non gravida neque vehicula. Sed tincidunt lobortis congue. Nullam congue ex ligula, non sagittis ipsum sodales eget.\n"
        "Fusce maximus velit eu congue consectetur. Vivamus efficitur eros eu magna mollis egestas. Morbi commodo pretium orci sit amet facilisis. Fusce a nulla vitae magna semper pellentesque non quis nulla. Cras tellus ligula, egestas at lorem non, rhoncus dictum dolor. Curabitur ut dolor in ex convallis pretium. Suspendisse id lacinia metus. Proin facilisis, mi id molestie porta, quam tortor facilisis arcu, quis faucibus mauris odio in urna. Etiam finibus ornare ullamcorper. Donec sit amet dui eu magna maximus pellentesque vehicula vel eros.\n"
        "Etiam euismod malesuada finibus. Nulla sit amet semper nisi, ut semper ante. Cras laoreet ante ligula, vel tincidunt arcu interdum vel. Nam leo neque, mollis sit amet felis sagittis, finibus efficitur magna. Donec finibus condimentum erat vel consequat. Sed molestie blandit aliquam. Integer ac justo vitae mauris condimentum scelerisque finibus a massa. Sed rhoncus, tellus at scelerisque varius, orci purus ultrices justo, et posuere elit leo efficitur metus. In nec mi urna. Donec elementum nisi non augue convallis aliquam. Duis dapibus mauris vel arcu fri",
        sizeof(buffer));
    while(true) {
        loop();
    }
}
