TheWaffleGuy/EPROM-programmer/(commit log)

2023-07-21 Some initial stuff
    [EPROM-programmer.kicad_sch]
2023-07-21 Add some LEDs
    [EPROM-programmer.kicad_sch]
2023-07-21 Add TODO
    [EPROM-programmer.kicad_sch]
2023-07-21 Wire-up ISP, ZIF and more
    [EPROM-programmer.kicad_sch]
2023-07-22 Add missing foot-prints
    [EPROM-programmer.kicad_sch]
2023-07-22 Add power-flags
    [EPROM-programmer.kicad_sch]
2023-07-23 Add DAC and more
    [EPROM-programmer.kicad_sch]
2023-07-24 Add some net-labels
    [EPROM-programmer.kicad_sch]
2023-07-24 Add missing footprint
    [EPROM-programmer.kicad_sch]
2023-07-24 Change to socket footprints
    [EPROM-programmer.kicad_sch]
2023-07-24 Very rough component placement
    [EPROM-programmer.kicad_pcb]
2023-07-24 Add pull-up for select-line for DAC
    [EPROM-programmer.kicad_pcb, EPROM-programmer.kicad_sch]
2023-07-24 Begin routing
    [EPROM-programmer.kicad_pcb]
2023-07-24 Add more routing
    [EPROM-programmer.kicad_pcb]
2023-07-25 Update connections to ZIF-socket
    [EPROM-programmer.kicad_pcb, EPROM-programmer.kicad_sch]
2023-07-25 Update 3D-models to populated sockets
    [EPROM-programmer.kicad_pcb]
2023-07-26 Add model for ZIF-socket
    [224-1275-00-0602J--3DModel-STEP-56544.STEP, EPROM-programmer.kicad_pcb]
2023-07-26 Minor adjustments
    [EPROM-programmer.kicad_pcb]
2023-07-26 Fix some DRC errors
    [EPROM-programmer.kicad_pcb]
2023-07-26 Initial version submitted for manufacturing
    [EPROM-programmer-B_Cu.gbl, EPROM-programmer-B_Mask.gbs, EPROM-programmer-B_Paste.gbp, EPROM-programmer-B_Silkscreen.gbo, EPROM-programmer-Edge_Cuts.gm1, EPROM-programmer-F_Cu.gtl, EPROM-programmer-F_Mask.gts, EPROM-programmer-F_Paste.gtp]
2023-07-26 Fix capacitor-stuff
    [EPROM-programmer.kicad_pcb, EPROM-programmer.kicad_sch]
2023-07-27 Begin design power
    [EPROM-programmer.kicad_sch, MC34063 DWS.XLS, power.kicad_sch]
2023-07-28 Fix input/output modes of pins
    [firmware.ino]
2023-07-28 Print help-text when an unknown command is issued
    [firmware.ino]
2023-07-29 Add missing return statements
    [firmware.ino]
2023-07-29 Stupid attempt at mocking arduino
2023-07-29 Avoid printf in print_record function
    [firmware.ino]
2023-07-29 Use consistent line-endings when printing serial
2023-07-29 Replace Serial.printf where trivial
    [firmware.ino, mock_arduino.cpp]
2023-07-29 Replace Serial.printf
2023-07-29 Print name of device after device selection
2023-07-30 Make commands case-insensitive
2023-07-31 Put device definitions in separate file
2023-07-31 Add more device definitions
2023-07-31 Add missing motorola chip
    [device_definitions.h, firmware.ino]
2023-07-31 Fix handling of blank-check
    [device_definitions.h, firmware.ino]
2023-08-12 Revert "Begin design power"
    This reverts commit d1b78c65f2bc72511ae88fe321f32b0fd5b265c9.
    [EPROM-programmer.kicad_sch, MC34063 DWS.XLS, power.kicad_sch]
2023-08-12 Revert "Fix capacitor-stuff"
    This reverts commit 9b25b860817774e3e25b1a31baa03ad3e26370b1.
    [EPROM-programmer.kicad_pcb, EPROM-programmer.kicad_sch]
2023-08-12 Add diodes to pins that will be used as VPP
    [EPROM-programmer.kicad_pcb, EPROM-programmer.kicad_sch]
2023-08-12 Add polarity indication to tantalum footprint
    [EPROM-programmer.kicad_pcb, EPROM-programmer.kicad_sch]
2023-08-13 Begin work on programmable VCC for ZIF
    [EPROM-programmer.kicad_sch]
2023-08-14 Add some capacitors
    [EPROM-programmer.kicad_sch]
2023-08-14 Add missing stuff
    [EPROM-programmer.kicad_sch]
2023-08-15 Move stuff
    [EPROM-programmer.kicad_pcb]
2023-08-15 Add reverse polarity protection diode
    [EPROM-programmer.kicad_sch]
2023-08-15 Do programmable VCC stuff
    [EPROM-programmer.kicad_pcb, EPROM-programmer.kicad_sch]
2023-08-15 Add new fabrication files
    [EPROM-programmer-B_Cu.gbl, EPROM-programmer-B_Mask.gbs, EPROM-programmer-B_Paste.gbp, EPROM-programmer-B_Silkscreen.gbo, EPROM-programmer-Edge_Cuts.gm1, EPROM-programmer-F_Cu.gtl, EPROM-programmer-F_Mask.gts, EPROM-programmer-F_Paste.gtp]
2023-08-26 Update arduino mock
2023-08-26 Only include arduino libs when compiling for arduino
2024-02-11 Add script for reseting the MCU
    [reset.py]
2024-06-16 WIP use LM317
    [EPROM-programmer.kicad_pcb, EPROM-programmer.kicad_sch]
2024-06-17 Fix some ERC/DRC
    [EPROM-programmer.kicad_pcb, EPROM-programmer.kicad_sch]
2024-06-17 Fix more DRC-errors
    [EPROM-programmer.kicad_pcb]
2024-06-18 Add LM317 for VPP
    [EPROM-programmer.kicad_pcb, EPROM-programmer.kicad_sch]
2024-06-18 Very minor adjustments
    [EPROM-programmer.kicad_pcb]
2024-06-18 Update fabrication files
    [EPROM-programmer-B_Cu.gbl, EPROM-programmer-B_Mask.gbs, EPROM-programmer-B_Paste.gbp, EPROM-programmer-B_Silkscreen.gbo, EPROM-programmer-Edge_Cuts.gm1, EPROM-programmer-F_Cu.gtl, EPROM-programmer-F_Mask.gts, EPROM-programmer-F_Paste.gtp]
2024-07-06 Update voltage calculation after change to LM317
2024-07-08 Set VPP as low as possible on reset
    [firmware.ino]
2024-07-14 Prevent buffer overflow on line input buffer
    [firmware.ino]
2024-07-21 Fix echo of characters sent by serial
    [firmware.ino]
2024-07-28 Fix device turn on and turn off
    [firmware.ino]
2024-07-29 Store device definitions in PROGMEM
2024-07-29 Update schematic with the missing VPP-stuff
    [EPROM-programmer.kicad_pcb, EPROM-programmer.kicad_sch]
2024-07-29 Route VPP-stuff
    [EPROM-programmer.kicad_pcb, EPROM-programmer.kicad_sch]
2024-07-29 Nudge some tracks around
    [EPROM-programmer.kicad_pcb]
2024-07-29 Add switching supply for VCC to ZIF-socket
    [EPROM-programmer.kicad_pcb, EPROM-programmer.kicad_sch]
2024-07-29 Use R-78K9.0-0.5 instead of R-78E9.0-0.5
    [EPROM-programmer.kicad_pcb, EPROM-programmer.kicad_sch]
2024-07-29 Minor adjustments to 3D-models
    [EPROM-programmer.kicad_pcb]
2024-07-29 Make room for heatsinks
    [CUI_DEVICES_HSE-B2111-038.step, EPROM-programmer.kicad_pcb]
2024-07-29 Switch to more common capacitor footprint for 220uf cap
    [EPROM-programmer.kicad_pcb, EPROM-programmer.kicad_sch]
2024-07-29 Remove some testpoints and clean up some stuff
    [EPROM-programmer.kicad_pcb, EPROM-programmer.kicad_sch]
2024-07-29 Remove 3D model for USB-port. It's been added to builtin 3D library
    [EPROM-programmer.kicad_pcb]
2024-07-29 Add info about polarity and voltage to PCB
    [EPROM-programmer.kicad_pcb]
2024-07-29 Prepare for using 2 layers instead of 4
    [EPROM-programmer.kicad_pcb, EPROM-programmer.kicad_sch]
2024-07-29 Increase PCB size. Rework PCB to use 2 layers
    [EPROM-programmer.kicad_pcb, EPROM-programmer.kicad_sch, Power.kicad_sch, Programmer.kicad_sch]
2024-07-29 Add input/output protection on data lines (WIP)
    [EPROM-programmer.kicad_pcb, Programmer.kicad_sch]
2024-07-29 Clean up of schematic
    [EPROM-programmer.kicad_pcb, Power.kicad_sch, Programmer.kicad_sch]
2024-07-29 Finish input/output protection on data lines
    [EPROM-programmer.kicad_pcb, Programmer.kicad_sch]
2024-07-29 Add aditional filter for 28v line
    [EPROM-programmer.kicad_pcb, Power.kicad_sch, Programmer.kicad_sch]
2024-07-29 Move version-number to front of PCB
    [EPROM-programmer.kicad_pcb]
2024-07-29 Generate new gerber-files
    [EPROM-programmer-B_Cu.gbl, EPROM-programmer-B_Mask.gbs, EPROM-programmer-B_Paste.gbp, EPROM-programmer-B_Silkscreen.gbo, EPROM-programmer-Edge_Cuts.gm1, EPROM-programmer-F_Cu.gtl, EPROM-programmer-F_Mask.gts, EPROM-programmer-F_Paste.gtp]
2024-07-29 Minor silk screen adjustments
    [EPROM-programmer.kicad_pcb]
2024-07-29 Regenerate gerber-files
    [EPROM-programmer-B_Cu.gbl, EPROM-programmer-B_Mask.gbs, EPROM-programmer-B_Paste.gbp, EPROM-programmer-B_Silkscreen.gbo, EPROM-programmer-Edge_Cuts.gm1, EPROM-programmer-F_Cu.gtl, EPROM-programmer-F_Mask.gts, EPROM-programmer-F_Paste.gtp]
2024-07-29 More silkscreen adjustments
    [EPROM-programmer-B_Cu.gbl, EPROM-programmer-B_Mask.gbs, EPROM-programmer-B_Paste.gbp, EPROM-programmer-B_Silkscreen.gbo, EPROM-programmer-Edge_Cuts.gm1, EPROM-programmer-F_Cu.gtl, EPROM-programmer-F_Mask.gts, EPROM-programmer-F_Paste.gtp]
2024-07-29 Adjust component values
    [EPROM-programmer.kicad_pcb, Power.kicad_sch]
2024-07-29 Increase base current to VCC transistor
    [EPROM-programmer.kicad_pcb, Programmer.kicad_sch]
2024-08-07 Change base resistors for VPP transistors
    [EPROM-programmer.kicad_pcb, Programmer.kicad_sch]
2024-08-09 Update to handle moving of pins in new PCB revision
2024-09-26 Start implementing calibration routine
2024-09-30 Fix? VCC calibration
2024-09-30 Fix calibration
2024-10-03 Add info about voltage calibration to help-menu
2024-10-04 Update device definitions
2024-10-05 Add VPP voltage to definitions
2024-10-05 Fix VPP voltage Signetics 27hc641
    [device_definitions.h]
2024-10-06 Add Programming pulse width to device definitions
2025-01-26 Add error message if arduino-cli isn't found
    [tool.py]
2025-01-27 Add OK! message after listing devices
2025-01-27 Make sure to always print "OK!" when a command executes successfully
2025-01-27 Save calibration to EEPROM
2025-01-28 Change error-logging to Exceptions
    [tool.py]
2025-01-28 Display error message when no programmer is found
    [tool.py]
2025-01-28 Remove debug print
2025-01-29 Put voltage offsets in a struct
2025-01-29 Add some device properties
2025-02-01 Handle 5v overprogramming
2025-02-01 Fix pw for devices with forced overprogramming
    [firmware.ino]
2025-02-01 Add confirm prompt when burning EPROM
    [firmware.ino]
2025-02-02 Select device by hex instead of decimal
2025-02-02 Add workaround for long delay
    [firmware.ino]
2025-02-02 Burn the whole EPROM
    [firmware.ino]
2025-02-02 Turn of all ouputs when turning off device Add untested version of 2532 programming
2025-02-04 Add a bit of delay to help slow devices
2025-02-06 Try to workaround some issues with slower devices
    [firmware.ino]
2025-02-07 Refactor VPP-pin handling
2025-02-26 Correct number of pulses WS57C43C
    [device_definitions.h]
2025-03-02 Add NMC27CxxH devices
2025-03-07 Read calibration before initializing device operations
2025-03-09 Prevent bug when enabling 2364 mode if it is already enabled
    [firmware.ino]
2025-03-09 Fix verify cypress during programming
    [device_operations.cpp]
2025-03-16 Only apply 2364-mode for compatible cypress devices
2025-03-29 Transmit in separate thread to not block UI
2025-04-05 Inital work on device select dialog
2025-04-14 Display selected device in toolbar
2025-04-14 Sync selected device on start up
2025-04-14 Split manufacturer and device name to different columns in device select
2025-04-15 Handle no device selected
2025-04-15 Handle search in device select better
2025-04-26 Handle data read from device and saving buffer to disk
2025-04-26 Do not join txThread if no such thread was created yet
2025-08-19 Start working on hw revision 1.4
    [EPROM-programmer.kicad_pcb, EPROM-programmer.kicad_sch, Power.kicad_sch, Programmer.kicad_sch]
2025-08-19 Fixes after KiCad 9 upgrade
    [EPROM-programmer.kicad_pcb, Power.kicad_sch, Programmer.kicad_sch]
2025-08-19 Redo layout after switching to LD1086
    [EPROM-programmer.kicad_pcb, Power.kicad_sch]
2025-08-19 Change a capacitor to a more common size
    [EPROM-programmer.kicad_pcb, Power.kicad_sch]
2025-08-20 Rearrange data overvoltage protection diodes
    [EPROM-programmer.kicad_pcb]
2025-08-20 Remove unnecessary external 3D models
    [EPROM-programmer.kicad_pcb]
2025-09-06 Minor adjustments primarily around data diodes
    [EPROM-programmer.kicad_pcb, Power.kicad_sch]
2025-09-10 Minor adjustments around VCC regulator
    [EPROM-programmer.kicad_pcb]
2026-01-23 Remove copying of data when listing devices with a filter string
2026-01-23 Fix display of device list in GUI
2026-01-25 Fix error when device list in UI was closed before complete list was retrieved
2026-02-14 Update device list
2026-02-18 Print some details when listing device info
2026-02-20 Add ability to specify voltage margin when verify/blank check EPROM
